ElRoscaoJr/time_machine/vistas/04-fijacion-pantalla.png

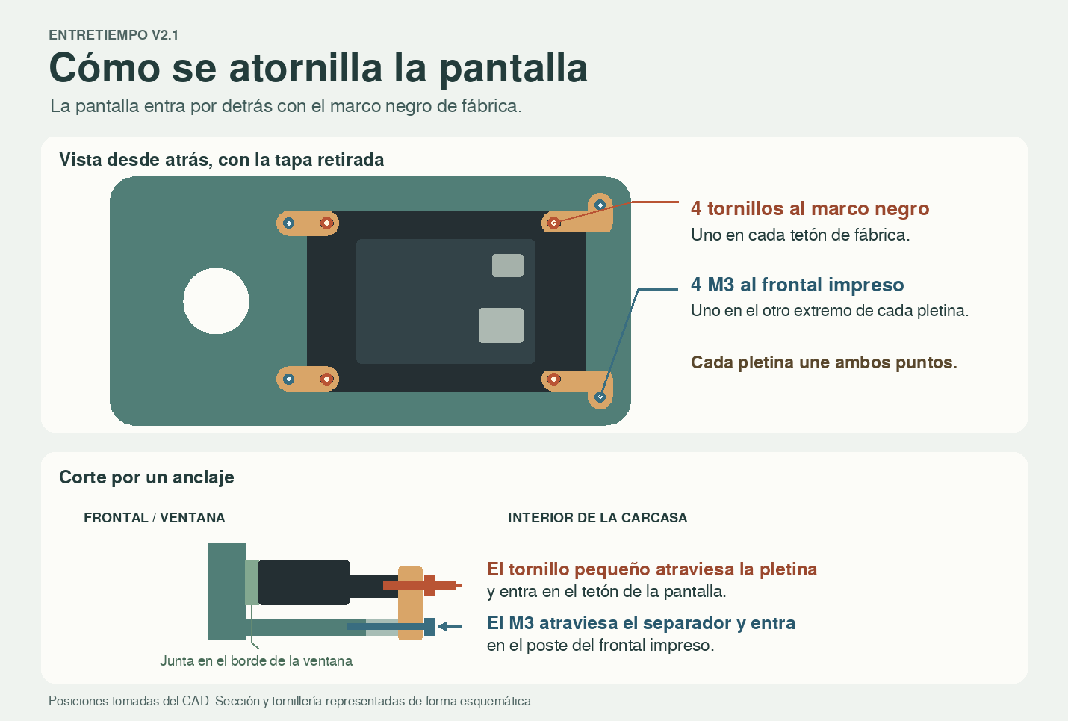
vistas/04-fijacion-pantalla.png
