ElRoscaoJr/time_machine/fabricacion/Entretiempo/Entretiempo-V2.1/fabricacion/Pruebas_y_alternativas/07-plantilla-pantalla.stl

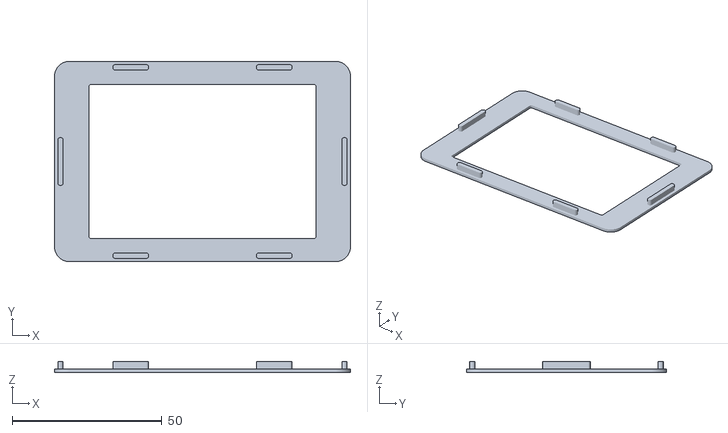
[picture p3: CAD file, 2026-11-12]
fabricacion/Entretiempo/Entretiempo-V2.1/fabricacion/Pruebas_y_alternativas/07-plantilla-pantalla.stl
99.0 x 67.0 x 3.60
