ElRoscaoJr/time_machine/fabricacion/Entretiempo/Entretiempo-V2.1/fabricacion/step/13-pletina-lado-opuesto.step

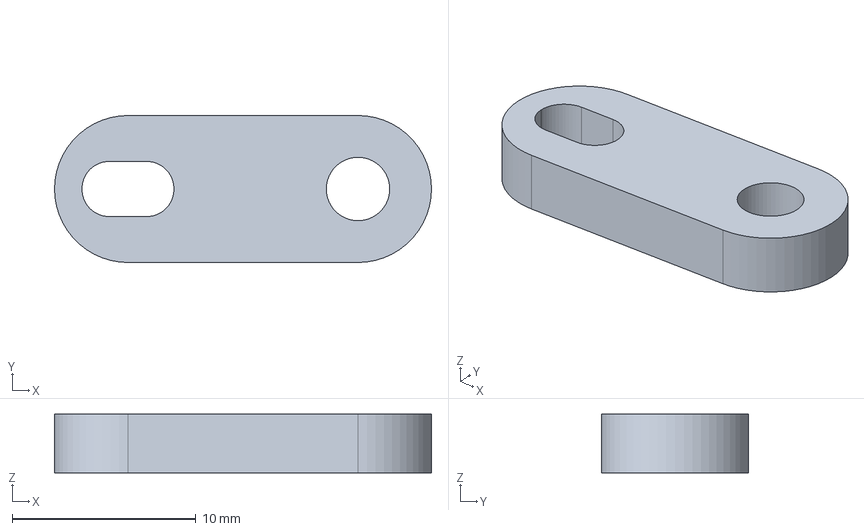
[picture p4: CAD file, 2026-11-13]
fabricacion/Entretiempo/Entretiempo-V2.1/fabricacion/step/13-pletina-lado-opuesto.step
20.5 x 8.00 x 3.20 mm
