ElRoscaoJr/time_machine/fabricacion/Entretiempo/Entretiempo-V2.1/fabricacion/stl/Exterior/01-frontal.stl

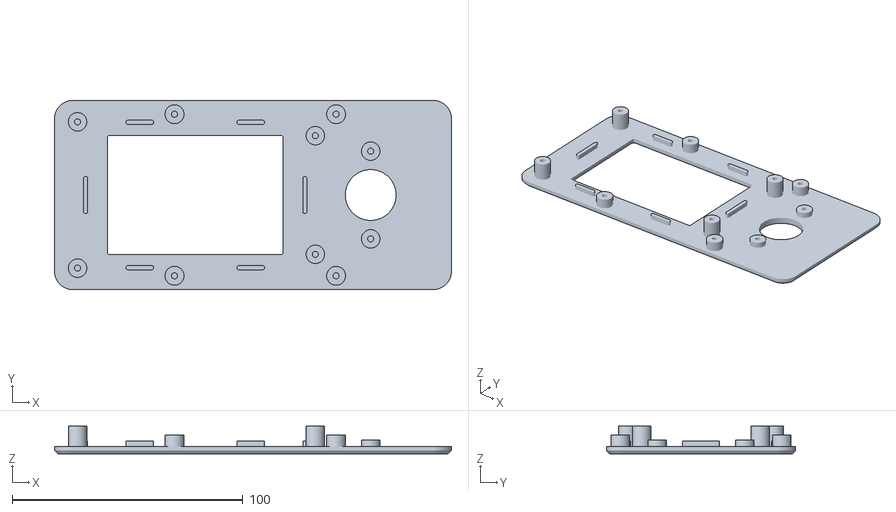
[picture p5: CAD file, 2026-11-13]
fabricacion/Entretiempo/Entretiempo-V2.1/fabricacion/stl/Exterior/01-frontal.stl
172.0 x 82.0 x 12.0
