ElRoscaoJr/time_machine/fabricacion/Entretiempo/Entretiempo-V2.1/fabricacion/stl/Interior/14-separador-pletina.stl

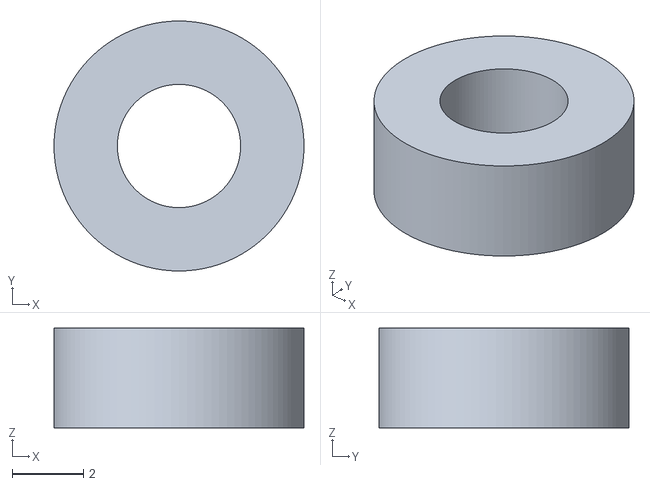
[picture p6: CAD file, 2026-11-13]
fabricacion/Entretiempo/Entretiempo-V2.1/fabricacion/stl/Interior/14-separador-pletina.stl
7.00 x 7.00 x 2.80
