ElRoscaoJr/time_machine/fabricacion/Entretiempo/Entretiempo-V2.1/fabricacion/Pruebas_y_alternativas/10-soporte-encoder-abrazadera.stl

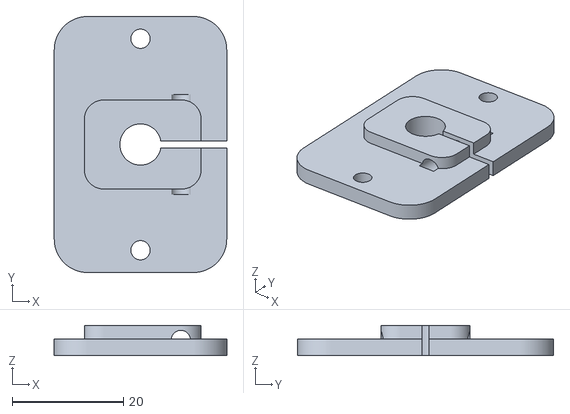
[picture p7: CAD file, 2026-11-12]
fabricacion/Entretiempo/Entretiempo-V2.1/fabricacion/Pruebas_y_alternativas/10-soporte-encoder-abrazadera.stl
31.0 x 46.0 x 5.40
