ElRoscaoJr/time_machine/fabricacion/Entretiempo/Entretiempo-V2.1/fabricacion/step/00-conjunto.step

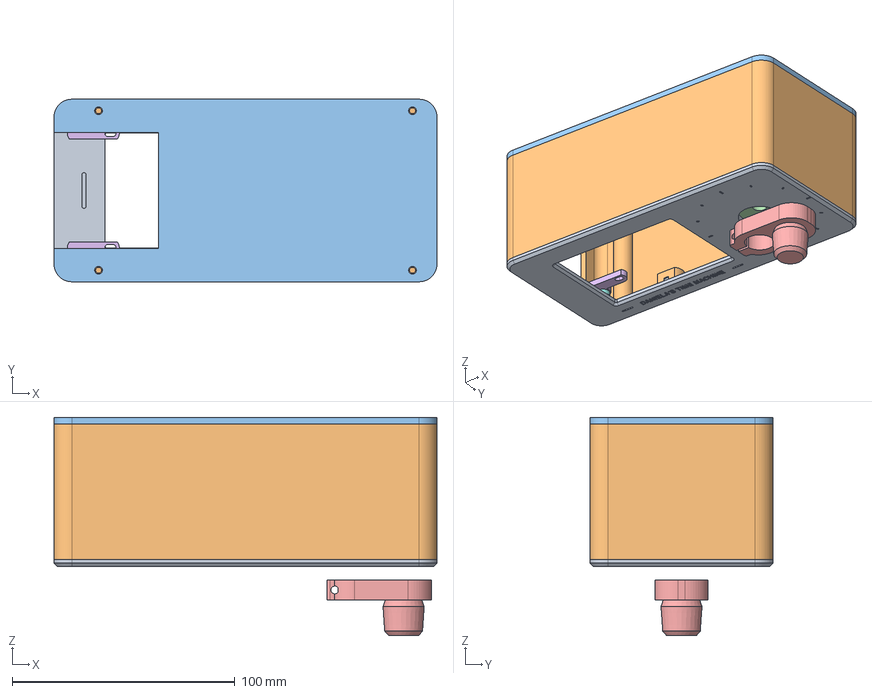
[picture p8: CAD file, 2026-11-13]
fabricacion/Entretiempo/Entretiempo-V2.1/fabricacion/step/00-conjunto.step
172.0 x 82.0 x 98.0 mm
01-frontal
02-cuerpo
03-tapa-bandeja
05-soporte-encoder
06-manivela
12-pletina-lado-puertos
13-pletina-lado-opuesto
12-pletina-lado-puertos-inferior
13-pletina-lado-opuesto-inferior
14-separador-3 x 2
14-separador-2
14-separador-4
