ElRoscaoJr/time_machine/fabricacion/Entretiempo/Entretiempo-V2.1/fabricacion/stl/Exterior/02-cuerpo.stl

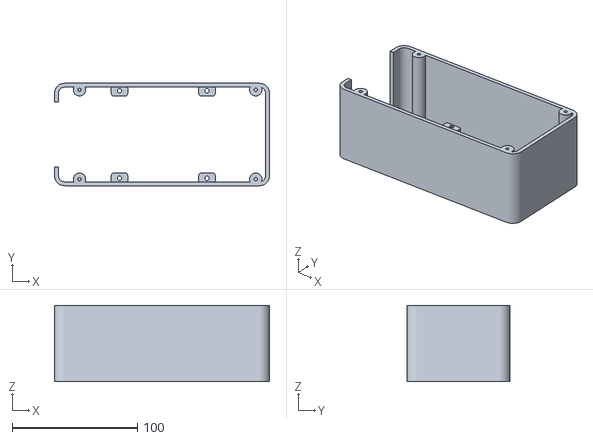
[picture p9: CAD file, 2026-11-12]
fabricacion/Entretiempo/Entretiempo-V2.1/fabricacion/stl/Exterior/02-cuerpo.stl
172.0 x 82.0 x 60.8
