ElRoscaoJr/time_machine/fabricacion/Entretiempo/Entretiempo-V2.1/fabricacion/Pruebas_y_alternativas/08-plantilla-mando.stl

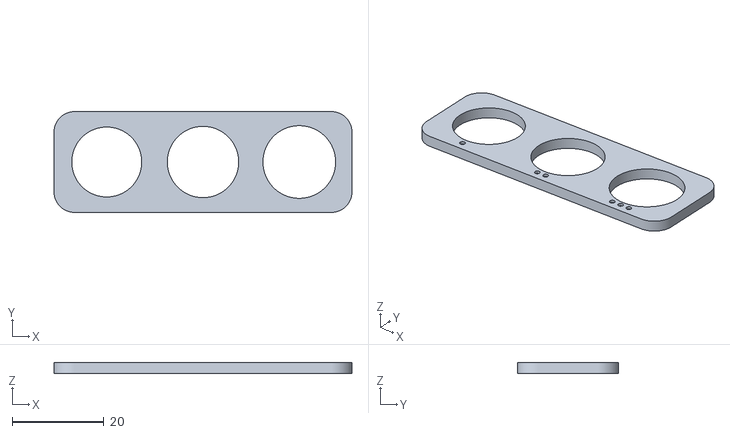
[picture p10: CAD file, 2026-11-12]
fabricacion/Entretiempo/Entretiempo-V2.1/fabricacion/Pruebas_y_alternativas/08-plantilla-mando.stl
65.0 x 22.0 x 2.40
