ElRoscaoJr/time_machine/fabricacion/Entretiempo/Entretiempo-V2.1/fabricacion/stl/Exterior/03-tapa-bandeja.stl

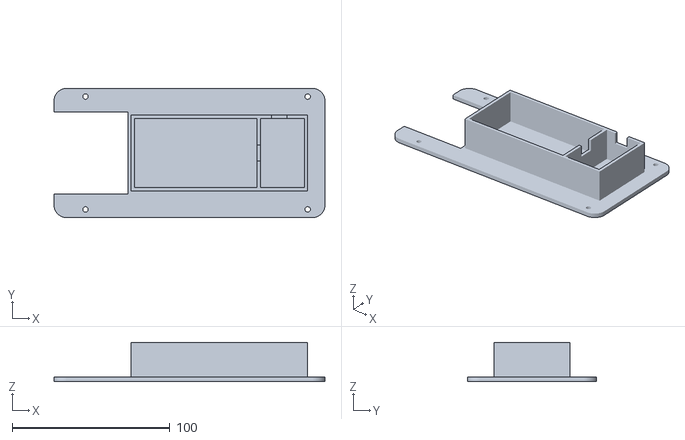
[picture p11: CAD file, 2026-11-12]
fabricacion/Entretiempo/Entretiempo-V2.1/fabricacion/stl/Exterior/03-tapa-bandeja.stl
172.0 x 82.0 x 25.0
