ElRoscaoJr/time_machine/fabricacion/Entretiempo/Entretiempo-V2.1/fabricacion/stl/Interior/12-pletina-lado-puertos.stl

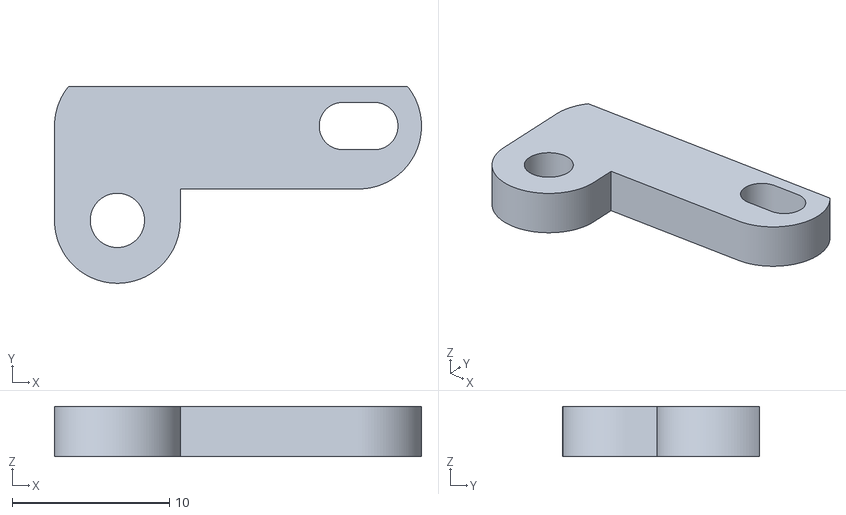
[picture p12: CAD file, 2026-11-13]
fabricacion/Entretiempo/Entretiempo-V2.1/fabricacion/stl/Interior/12-pletina-lado-puertos.stl
23.3 x 12.5 x 3.20
