ElRoscaoJr/time_machine/fabricacion/Entretiempo/Entretiempo-V2.1/fabricacion/Pruebas_y_alternativas/04-rail-pantalla.stl

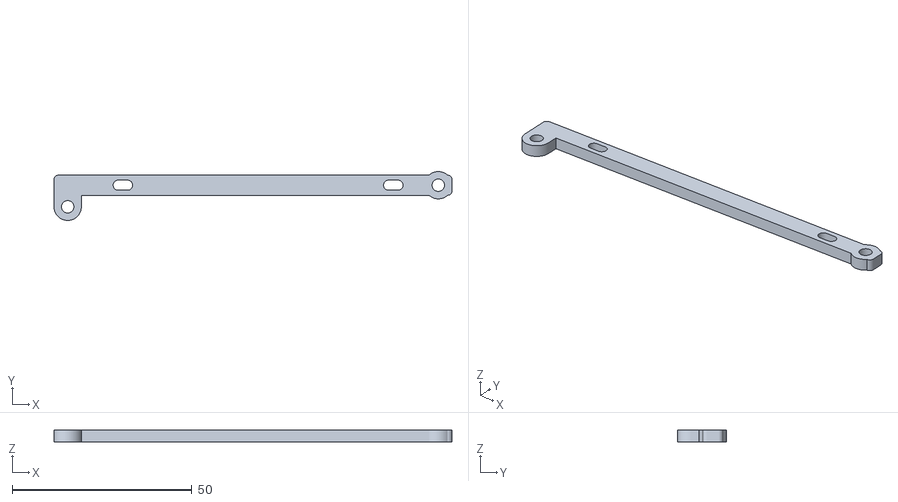
[picture p13: CAD file, 2026-11-12]
fabricacion/Entretiempo/Entretiempo-V2.1/fabricacion/Pruebas_y_alternativas/04-rail-pantalla.stl
110.6 x 13.6 x 3.20
