ElRoscaoJr/time_machine/fabricacion/Entretiempo/Entretiempo-V2.1/fabricacion/stl/Exterior/06-manivela.stl

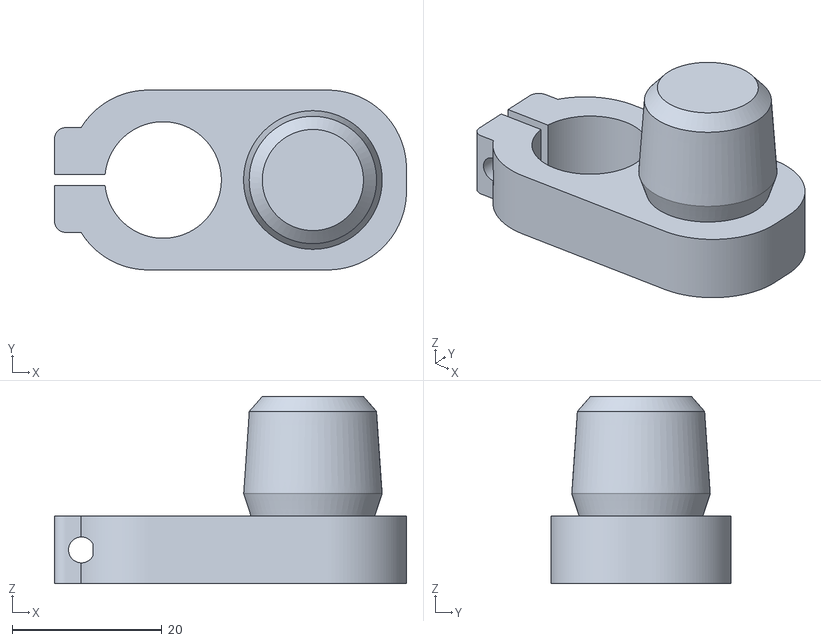
[picture p14: CAD file, 2026-11-12]
fabricacion/Entretiempo/Entretiempo-V2.1/fabricacion/stl/Exterior/06-manivela.stl
47.0 x 24.0 x 25.0
