ElRoscaoJr/time_machine/fabricacion/Entretiempo/Entretiempo-V2.1/fabricacion/stl/Interior/05-soporte-encoder.stl

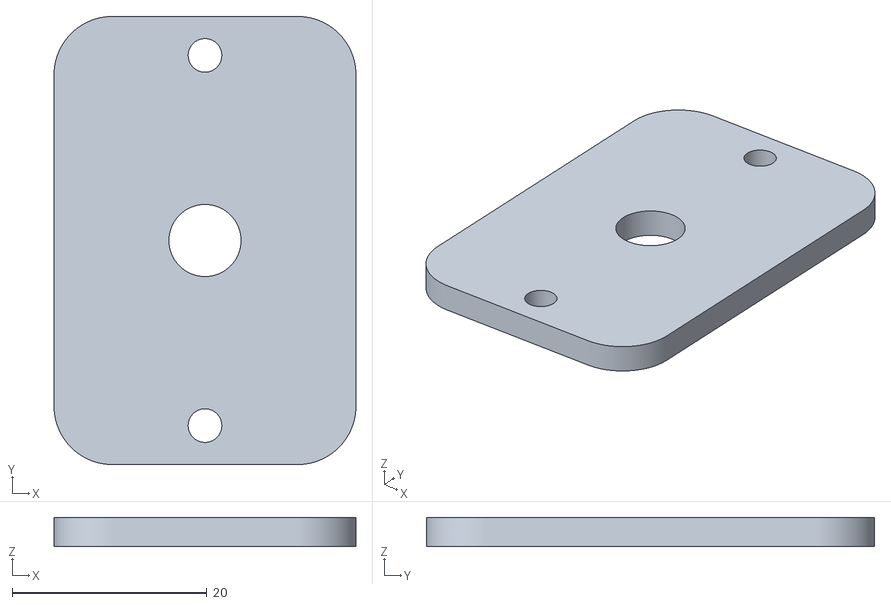
[picture p15: CAD file, 2026-11-12]
fabricacion/Entretiempo/Entretiempo-V2.1/fabricacion/stl/Interior/05-soporte-encoder.stl
31.0 x 46.0 x 3.00
