ElRoscaoJr/time_machine/fabricacion/Entretiempo/Entretiempo-V2.1/fabricacion/Pruebas_y_alternativas/09-soporte-encoder-piloto.stl

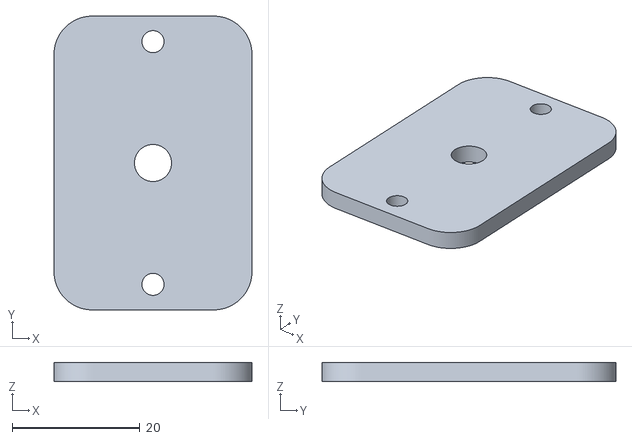
[picture p16: CAD file, 2026-11-12]
fabricacion/Entretiempo/Entretiempo-V2.1/fabricacion/Pruebas_y_alternativas/09-soporte-encoder-piloto.stl
31.0 x 46.0 x 3.00
