ElRoscaoJr/time_machine/fabricacion/Entretiempo/Entretiempo-V2.1/fabricacion/step/06-manivela.step

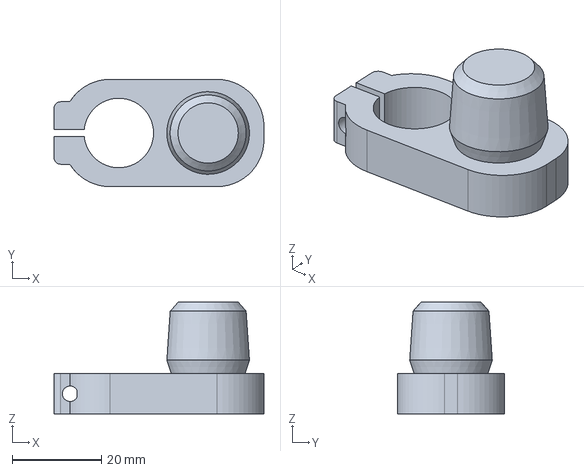
[picture p17: CAD file, 2026-11-12]
fabricacion/Entretiempo/Entretiempo-V2.1/fabricacion/step/06-manivela.step
47.0 x 24.0 x 25.0 mm
