ElRoscaoJr/time_machine/fabricacion/Entretiempo/Entretiempo-V2.1/fabricacion/step/08-plantilla-mando.step

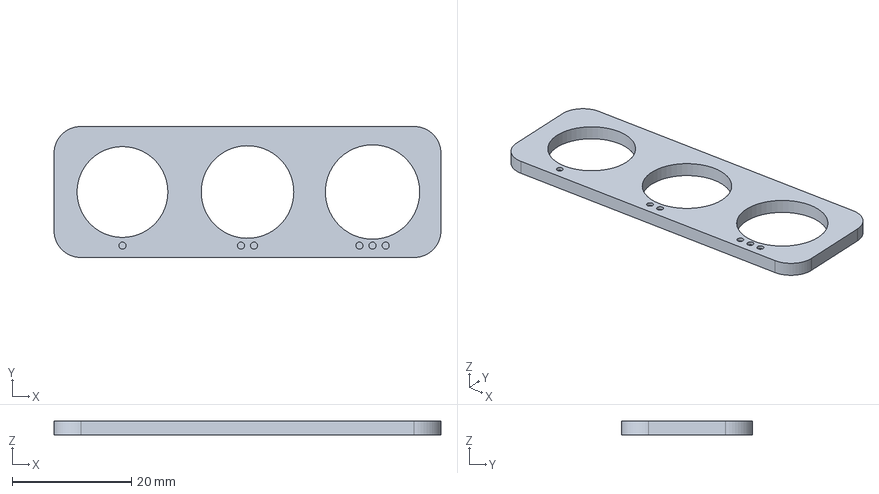
[picture p18: CAD file, 2026-11-12]
fabricacion/Entretiempo/Entretiempo-V2.1/fabricacion/step/08-plantilla-mando.step
65.0 x 22.0 x 2.40 mm
