ElRoscaoJr/time_machine/(list of files, cad)

Other CAD files:
fabricacion/Entretiempo/Entretiempo-V2.1/fabricacion/stl/Interior/13-pletina-lado-opuesto.stl
fabricacion/Entretiempo/Entretiempo-V2.1/fabricacion/step/14-separador-pletina.step
fabricacion/step/01-frontal.step
fabricacion/Entretiempo/Entretiempo-V2.1/fabricacion/step/12-pletina-lado-puertos.step
fabricacion/step/14-separador-pletina.step
fabricacion/Entretiempo/Entretiempo-V2.1/fabricacion/Pruebas_y_alternativas/11-abrazadera-piloto.stl
fabricacion/Entretiempo/Entretiempo-V2.1/fabricacion/step/01-frontal.step
fabricacion/step/12-pletina-lado-puertos.step
fabricacion/Entretiempo/Entretiempo-V2.1/fabricacion/step/04-rail-pantalla.step
fabricacion/Entretiempo/Entretiempo-V2.1/fabricacion/step/02-cuerpo.step
fabricacion/Entretiempo/Entretiempo-V2.1/fabricacion/step/03-tapa-bandeja.step
fabricacion/Entretiempo/Entretiempo-V2.1/fabricacion/step/10-soporte-encoder-abrazadera.step
fabricacion/Entretiempo/Entretiempo-V2.1/fabricacion/step/09-soporte-encoder-piloto.step
fabricacion/Entretiempo/Entretiempo-V2.1/fabricacion/step/11-abrazadera-piloto.step
fabricacion/Entretiempo/Entretiempo-V2.1/fabricacion/step/07-plantilla-pantalla.step
fabricacion/Entretiempo/Entretiempo-V2.1/fabricacion/step/05-soporte-encoder.step
fabricacion/stl/13-pletina-lado-opuesto.stl
