ElRoscaoJr/time_machine/fabricacion/Entretiempo/Entretiempo-V2.1/vistas/02-interior.png

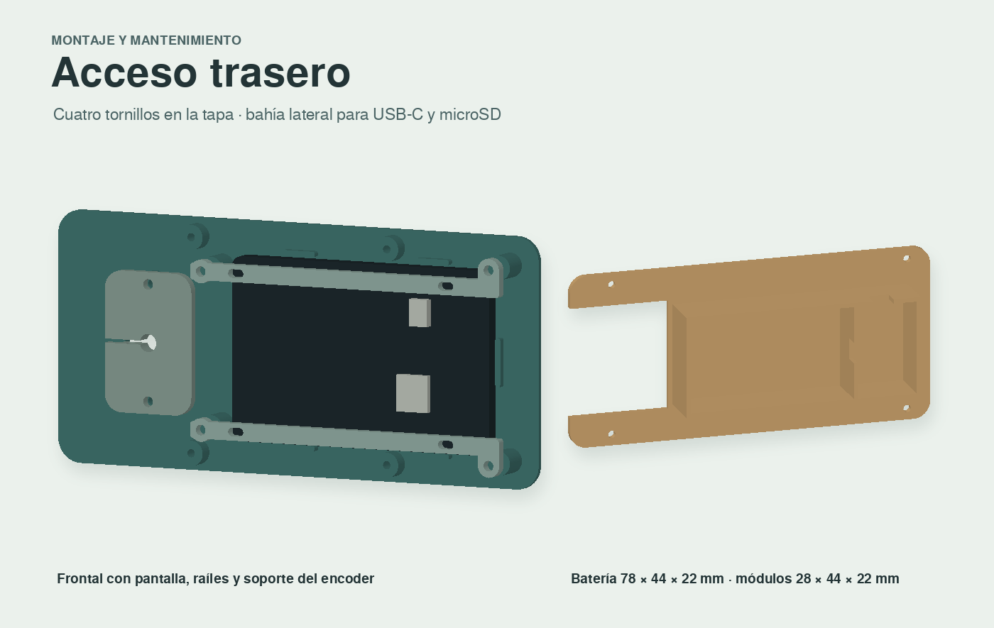
fabricacion/Entretiempo/Entretiempo-V2.1/vistas/02-interior.png
