ElRoscaoJr/time_machine/fabricacion/Entretiempo/Entretiempo-V2.1/vistas/03-despiece.png

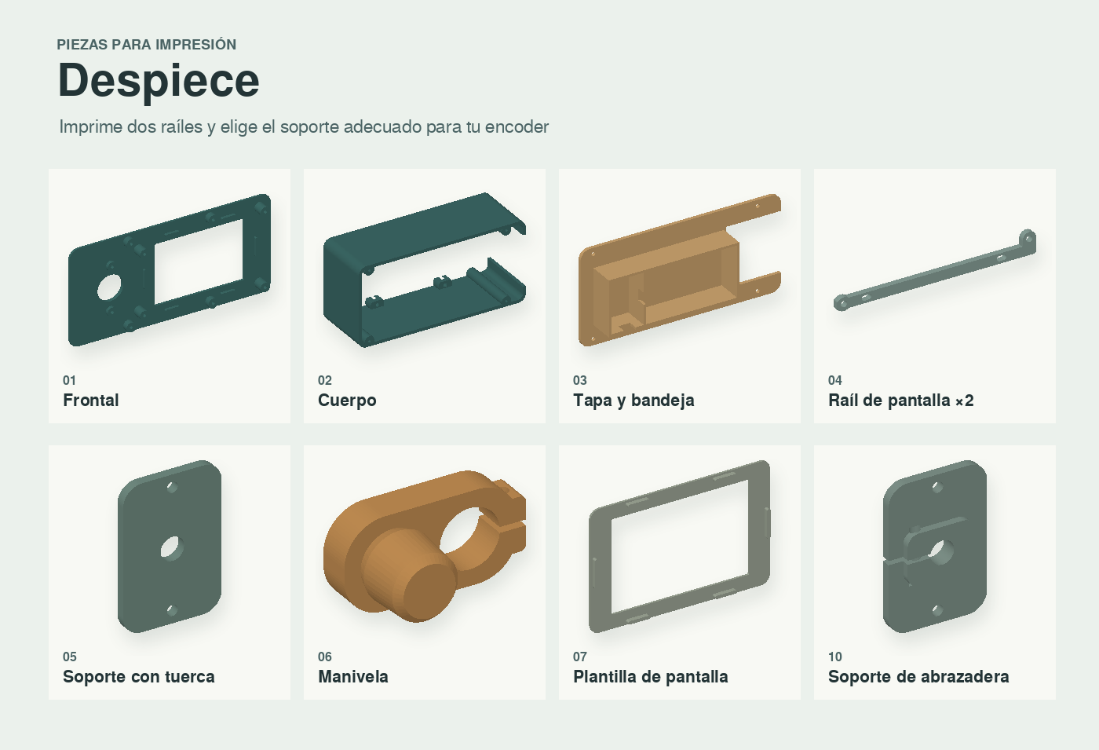
fabricacion/Entretiempo/Entretiempo-V2.1/vistas/03-despiece.png
