ElRoscaoJr/time_machine/firmware/main/config.h

#pragma once
#include "device_profile.h"
#ifndef PROFILE_NAME
#define PROFILE_NAME ""
#endif
#ifndef PROFILE_BIRTH
#define PROFILE_BIRTH 0
#endif
#ifndef AP_PASSWORD
#define AP_PASSWORD ""
#endif
#define AP_NAME "time_machine"
#define TIMEZONE "CET-1CEST,M3.5.0,M10.5.0/3"
