ElRoscaoJr/time_machine/(commit log)

2026-11-12 Document Entretiempo V2 assembly and printing
    [00-conjunto.step, 01-frontal.step, 01-frontal.stl, 02-cuerpo.step, 02-cuerpo.stl, 03-tapa-bandeja.step, 03-tapa-bandeja.stl, 04-rail-pantalla.step]
2026-11-13 Update project files
    [00-conjunto.step, 01-frontal.step, 01-frontal.stl, 02-cuerpo.step, 02-cuerpo.stl, 03-tapa-bandeja.step, 03-tapa-bandeja.stl, 04-rail-pantalla.step]
